Lightning1984/BlueDiamondPumpKNXInterface/Docu/StateChart.pdf

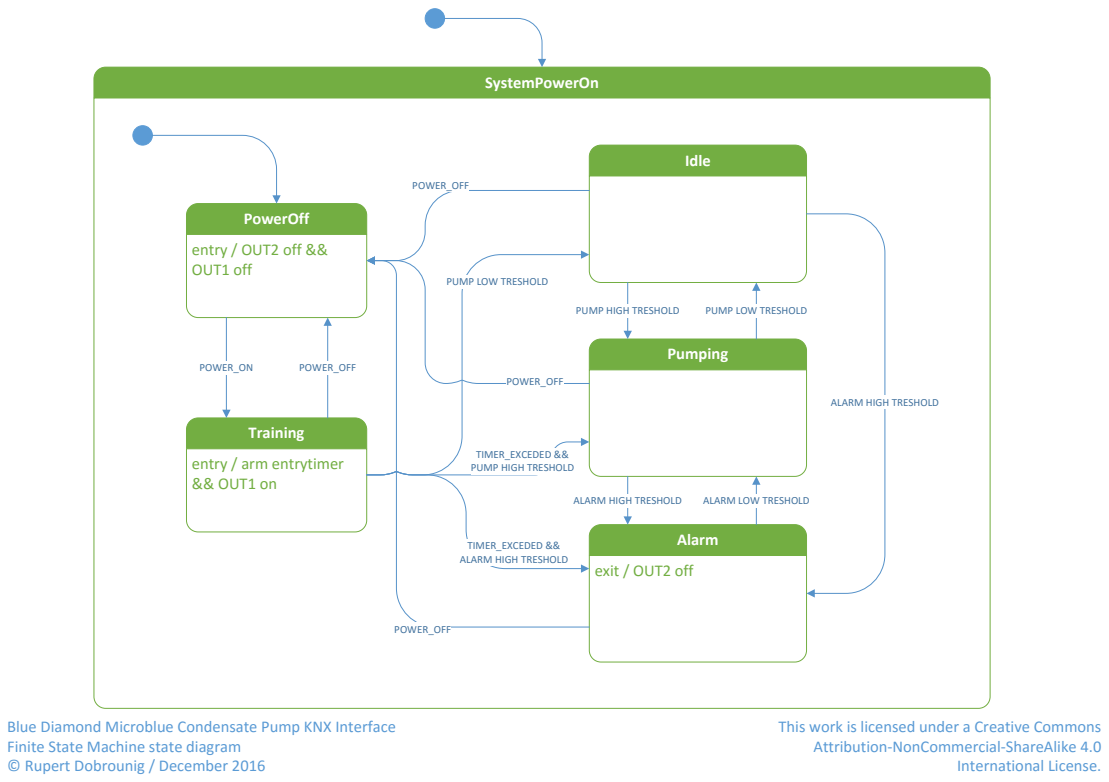
[picture p1: page 1]
SystemPowerOn; PowerOff; entry / OUT2 off && OUT1 off; Training; Idle; Pumping; Alarm; exit / OUT2 off; POWER_ON; POWER_OFF; ALARM HIGH TRESHOLD; ALARM LOW TRESHOLD; International License.

PUMP LOW TRESHOLD

PUMP HIGH TRESHOLD

ALARM HIGH TRESHOLD

TIMER_EXCEDED &&

entry / arm entrytimer
&& OUT1 on

Blue Diamond Microblue Condensate Pump KNX Interface
Finite State Machine state diagram
© Rupert Dobrounig / December 2016

This work is licensed under a Creative Commons
Attribution‐NonCommercial‐ShareAlike 4.0
