Lightning1984/BlueDiamondPumpKNXInterface/HW/LPC_2TE_3.11PEsmd_only-rdob-millable.brd

## EAGLE design HW/LPC_2TE_3.11PEsmd_only-rdob-millable.brd (2016-12-16)

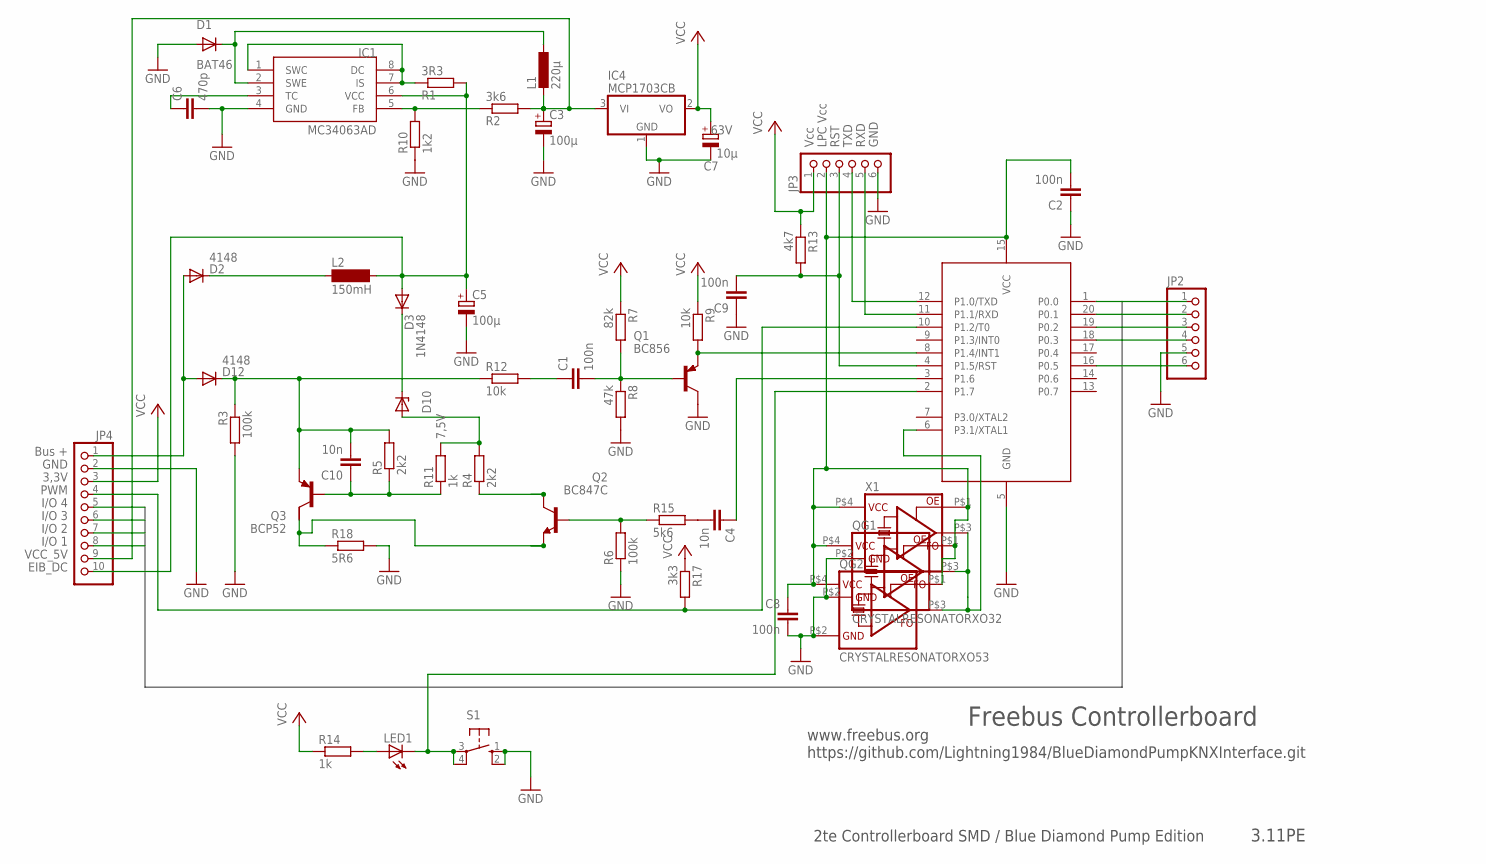
[picture p2: schematic LPC_2TE_3.11PEsmd_only-rdob-millable.sch]

Parts:
C1, C2, C8, C9: 100n; C0805K
C3: 100µ; E2,5-6
C4, C10: 10n; C0805K
C5: 100µ; E3,5-8
C6: 470p; C0805K
C7: 10µ; E2-5; VOLTAGE 63V
D1: BAT46; SOD-123
D2, D12: 4148; MINIMELF
D3: 1N4148; MINIMELF
D10: 7,5V; MINIMELF
IC1: MC34063AD; SOIC8
IC2: LPC922FDH; TSSOP20
IC4: MCP1703CB; SOT23
JP2: PINHD-1X06_2.54-0.70MM-DRILL; 1X06-0.70DRILL
JP3: PINHD-1X06_2.54-0.90MM-DRILL; 1X06-0.90DRILL
JP4: PINHD-1X10_2.54-S0.70MM-DRILL; 1X10-0.70DRILL
L1: 220µ; PIS28XX
L2: 150mH; BS11
LED1: LEDSMT1206; 1206
Q1: BC856; SOT23-BEC
Q2: BC847C; SOT23
Q3: BCP52; SOT223
QG1: CRYSTALRESONATORXO32; XO32
QG2: CRYSTALRESONATORXO53; XO53
R1: 3R3; R1206
R2: 3k6; R1206
R3, R6: 100k; R1206
R4, R5: 2k2; R1206
R7: 82k; R1206
R8: 47k; R1206
R9, R12: 10k; R1206
R10: 1k2; R1206
R11, R14: 1k; R1206
R13: 4k7; R1206
R15: 5k6; R1206
R17: 3k3; R1206
R18: 5R6; R1206
S1: 10-XX; B3F-10XX
X1: CRYSTALRESONATORXO91; XO91

Connections:
/RESET: C9.2, IC2.4 (P1.5/RST), JP3.3, R13.2
BASE: C1.2, Q1.B, R7.2, R8.1
BASE_SEND: Q2.1 (B), R6.2, R15.1
EIB+: D2.A, D12.A, JP4.1
EIB_DC: C5.+, D3.A, IC1.6 (VCC), JP4.10, L2.2, R1.2
FEEDBACK: IC1.5 (FB), R2.1, R10.2
GND: C2.1, C3.-, C5.-, C6.2, C7.-, C8.2, C9.1, D1.A, IC1.4 (GND), IC2.5 (GND), IC4.1 (GND), JP2.5, JP3.6, JP4.2, Q1.C, QG1.P$2 (GND), QG2.P$2 (GND), R3.2, R6.1, R8.2, R10.1, R18.2, S1.1 (S), S1.2 (S1), X1.P$2 (GND)
I_SENSE: Q2.2 (E), Q3.2 (C), R18.1
unnamed: Q2.3 (C), R4.1
unnamed: C10.2, D12.C, Q3.3 (E), R3.1, R5.2, R12.1
unnamed: IC2.6 (P3.1/XTAL1), QG1.P$3 (FO), QG2.P$3 (FO), X1.P$3 (FO)
unnamed: IC1.1 (SWC), IC1.7 (IS), IC1.8 (DC), R1.1
unnamed: LED1.A, R14.2
unnamed: D2.C, L2.1
unnamed: C6.1, IC1.3 (TC)
unnamed: D3.C, D10.C
unnamed: C1.1, R12.2
unnamed: C4.2, R15.2
unnamed: C10.1, Q3.1 (B), R5.1, R11.1
P0.0: IC2.1 (P0.0), JP2.1, JP4.8
P0.1: IC2.20 (P0.1), JP2.2, JP4.7
P0.2: IC2.19 (P0.2), JP2.3, JP4.6
P0.3: IC2.18 (P0.3), JP2.4, JP4.5
P0.5: IC2.16 (P0.5), JP2.6
PROG: IC2.2 (P1.7), LED1.C, S1.3, S1.4 (P1)
PWM: IC2.10 (P1.2/T0), JP4.4, R17.2
REFERENZ: D10.A, R4.2, R11.2
RXD: IC2.11 (P1.1/RXD), JP3.5
SIGIN: IC2.8 (P1.4/INT1), Q1.E, R9.2
SIGOUT: C4.1, IC2.3 (P1.6)
SWITCHED: D1.C, IC1.2 (SWE), L1.2 (1)
TXD: IC2.12 (P1.0/TXD), JP3.4
VCC: C7.+, IC4.2 (VO), JP3.1, JP4.3, R7.1, R9.1, R13.1, R14.1, R17.1
VCC_5V: C3.+, IC4.3 (VI), JP4.9, L1.1 (2), R2.2
VCC_LPC: C2.2, C8.1, IC2.15 (VCC), JP3.2, QG1.P$1 (OE), QG1.P$4 (VCC), QG2.P$1 (OE), QG2.P$4 (VCC), X1.P$1 (OE), X1.P$4 (VCC)

Notes on the sheet:
Bus +
GND
3,3V
PWM
I/O 1
I/O 2
I/O 3
I/O 4
Vcc
LPC Vcc
RST
TXD
RXD
VCC_5V
Freebus Controllerboard
www.freebus.org https://github.com/Lightning1984/BlueDiamondPumpKNXInterface.git
2te Controllerboard SMD / Blue Diamond Pump Edition
3.11PE
EIB_DC

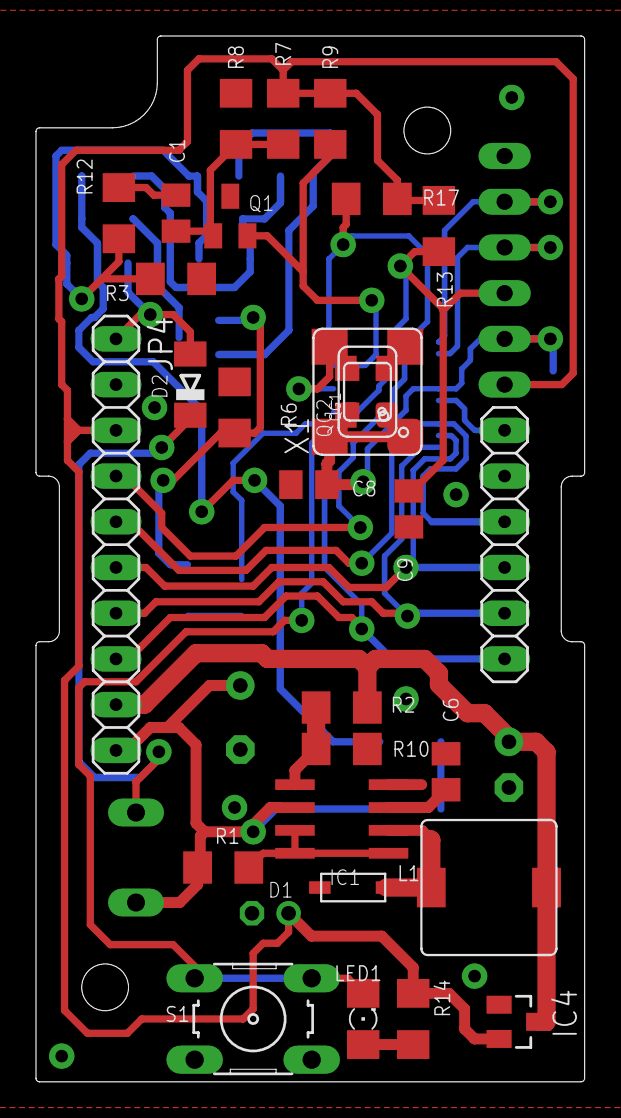
[picture p3: board LPC_2TE_3.11PEsmd_only-rdob-millable.brd from above]

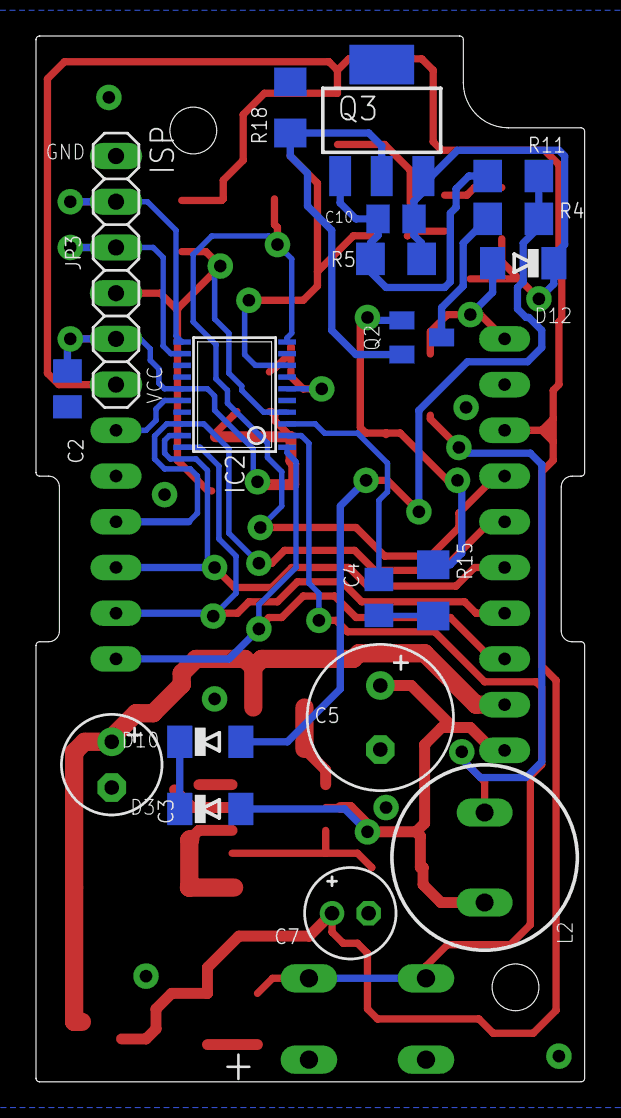
[picture p4: board LPC_2TE_3.11PEsmd_only-rdob-millable.brd from below]

Board: 2 copper layers, 30.5 x 58.1 mm, 48 parts (19 on the bottom side), 35 nets.
