Lightning1984/BlueDiamondPumpKNXInterface/HW/MicroBlue-CPU+PSU_1.0_rdob-millable.brd

## EAGLE design HW/MicroBlue-CPU+PSU_1.0_rdob-millable.brd (2016-12-16)

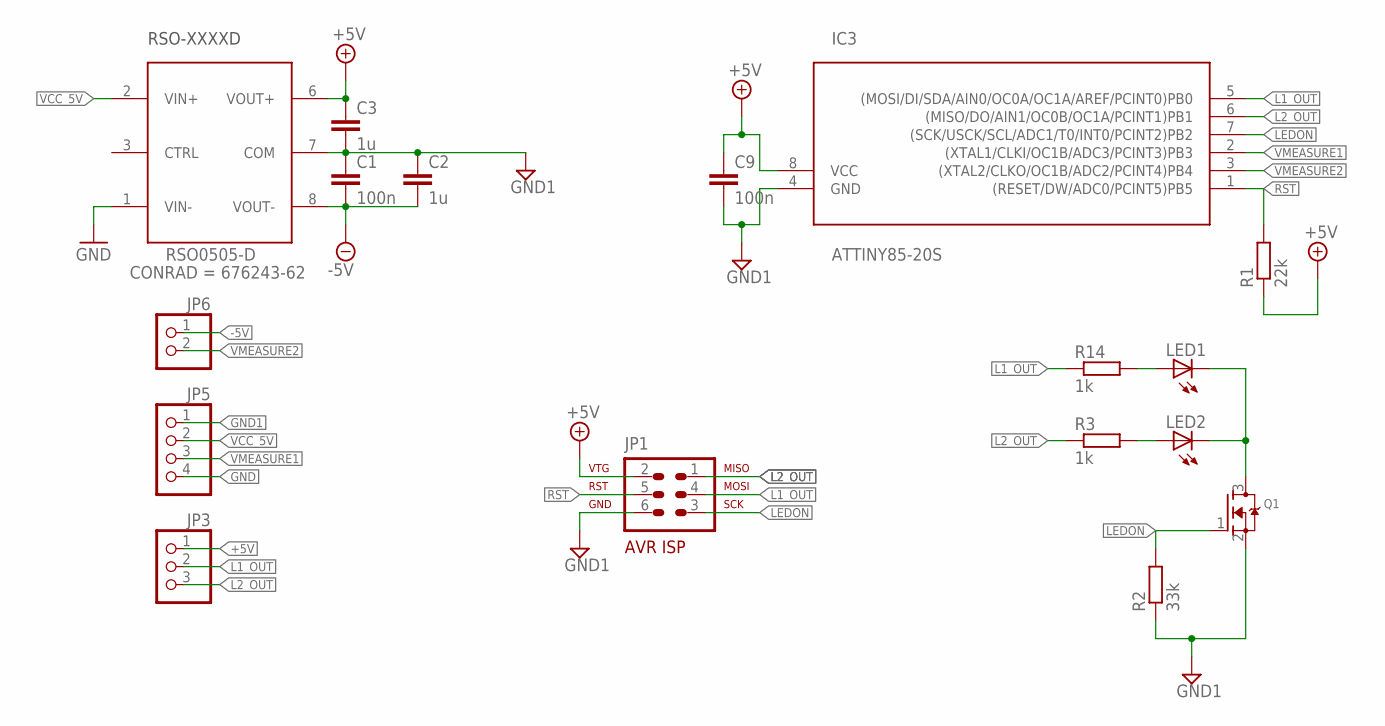
[picture p5: schematic MicroBlue-CPU+PSU_1.0_rdob-millable.sch]

Parts:
C1, C9: 100n; C0805K
C2, C3: 1u; C0805K
IC3: ATTINY85-20S; SOIC8
JP1: AVR-ISP-6R
JP3: PINHD-1X03_2.54-0.90MM-DRILL; 1X03-0.90DRILL
JP5: PINHD-1X04_2.54-0.90MM-DRILL; 1X04-0.90DRILL
JP6: PINHD-1X02_2.54-0.90MM-DRILL; 1X02-0.90DRILL
LED1, LED2: LEDSMT1206; 1206
Q1: MOSFET-NREFLOW; SOT23
R1: 22k; R1206
R2: 33k; R1206
R3, R14: 1k; R1206
RSO0505-D: RSO-0505D; RSO-XXXX

Connections:
+5V: C3.1, C9.1, IC3.8 (VCC), JP1.2, JP3.1, R1.1, RSO0505-D.6 (VOUT+)
-5V: C1.2, C2.2, JP6.1, RSO0505-D.8 (VOUT-)
GND: JP5.4, RSO0505-D.1 (VIN-)
GND1: C1.1, C2.1, C3.2, C9.2, IC3.4 (GND), JP1.6, JP5.1, Q1.2 (S), R2.1, RSO0505-D.7 (COM)
L1_OUT: IC3.5 ((MOSI/DI/SDA/AIN0/OC0A/OC1A/AREF/PCINT0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), JP1.4, JP3.2, R14.1
L2_OUT: IC3.6 ((MISO/DO/AIN1/OC0B/OC1A/PCINT1)PB1), JP1.1, JP3.3, R3.1
LEDON: IC3.7 ((SCK/USCK/SCL/ADC1/T0/INT0/PCINT2)PB2), JP1.3, Q1.1 (G), R2.2
unnamed: LED2.A, R3.2
unnamed: LED1.A, R14.2
PROG: LED1.C, LED2.C, Q1.3 (D)
RST: IC3.1 ((RESET/DW/ADC0/PCINT5)PB5), JP1.5, R1.2
VCC_5V: JP5.2, RSO0505-D.2 (VIN+)
VMEASURE1: IC3.2 ((XTAL1/CLKI/OC1B/ADC3/PCINT3)PB3), JP5.3
VMEASURE2: IC3.3 ((XTAL2/CLKO/OC1B/ADC2/PCINT4)PB4), JP6.2

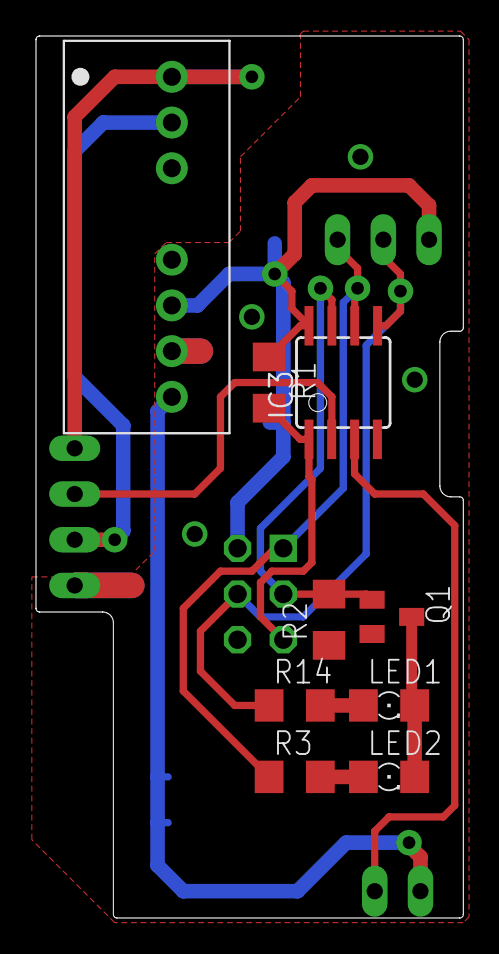
[picture p6: board MicroBlue-CPU+PSU_1.0_rdob-millable.brd from above]

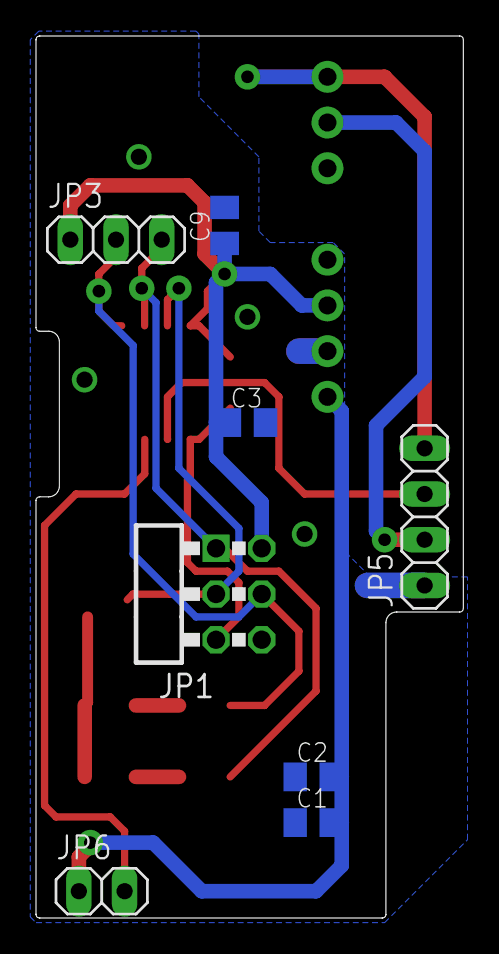
[picture p7: board MicroBlue-CPU+PSU_1.0_rdob-millable.brd from below]

Board: 2 copper layers, 23.7 x 49.0 mm, 17 parts (8 on the bottom side), 14 nets.
