Lightning1984/BlueDiamondPumpKNXInterface/HW/MicroBlue_1.0_rdob-millable.brd

## EAGLE design HW/MicroBlue_1.0_rdob-millable.brd (2016-12-16)

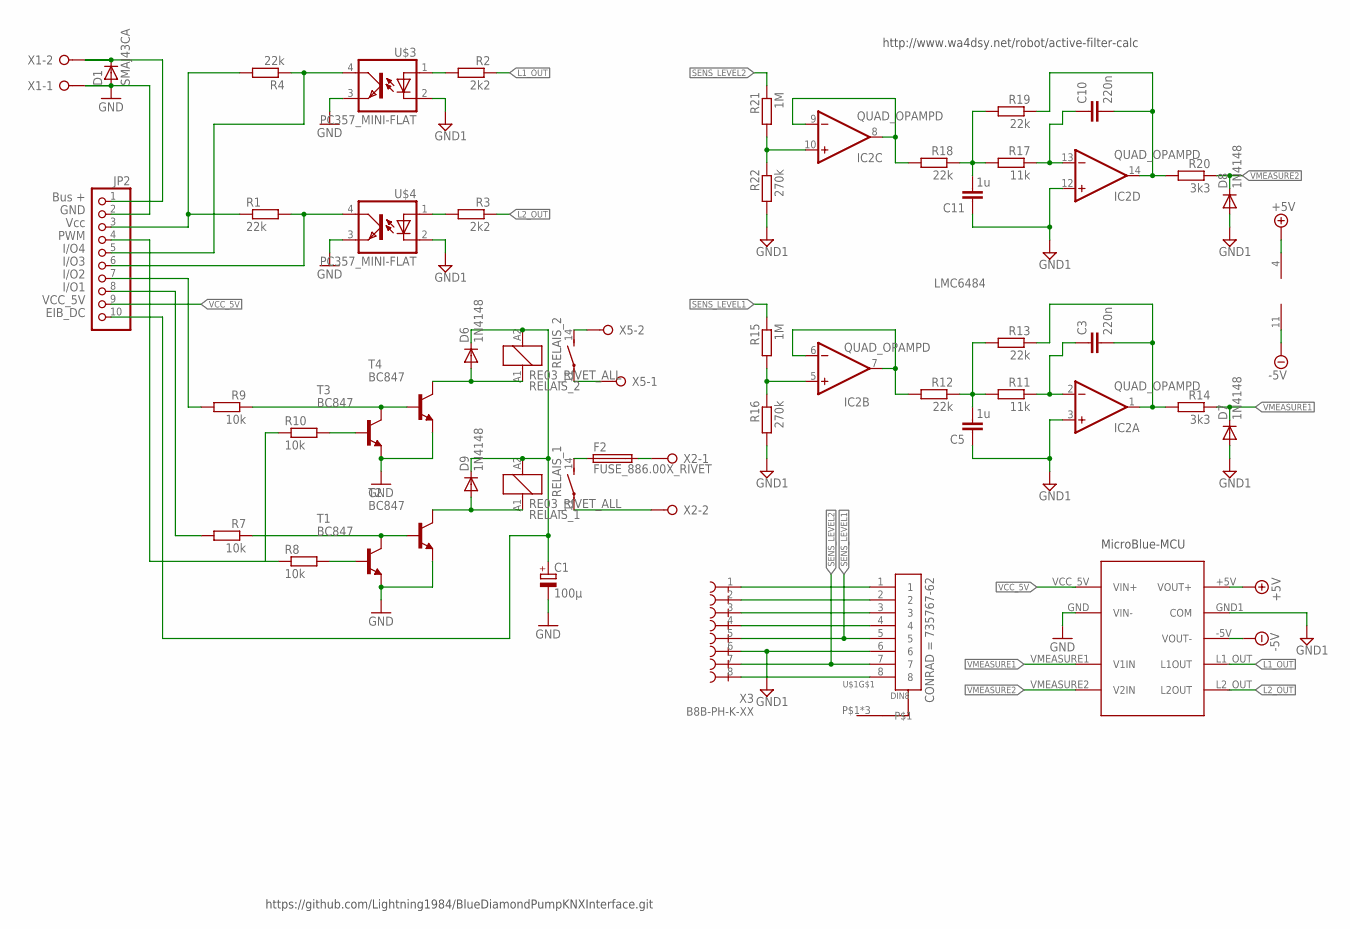
[picture p8: schematic MicroBlue_1.0_rdob-millable.sch]

Parts:
C1: 100µ; E3,5-8
C3, C10: 220n; C0805K
C5, C11: 1u; C0805K
D1: SMAJ43CA; SMB
D6, D7, D8, D9: 1N4148; MINIMELF
F2: FUSE_886.00X_RIVET; 886.00X_RIVET
IC2: QUAD_OPAMPD; SO14
JP2: PINHD-1X10_2.54-S0.90MM-DRILL; 1X10-0.90DRILL
R1, R4, R12, R13, R18, R19: 22k; M1206
R2, R3: 2k2; M1206
R7, R8, R9, R10: 10k; M1206
R11, R17: 11k; M1206
R14, R20: 3k3; M1206
R15, R21: 1M; M1206
R16, R22: 270k; M1206
RELAIS_1, RELAIS_2: RE03_RIVET_ALL; G5Q-SPST-RIVET-ALL
T1, T2, T3, T4: BC847; SOT23
U$1: DIN8
U$3, U$4: PC357_MINI-FLAT; PC357
U$5: MICROBLUE-MCU_V2; MICROBLUE-MCU-V2
X1: W237-02PNORMAL; W237-132
X2, X5: W237-02P_RIVET; W237-132-RIVET
X3: B8B-PH-K-XX

Connections:
+5V: IC2.4 (V+), U$5.+5V (VOUT+)
-5V: IC2.11 (V-), U$5.-5V (VOUT-)
EIB+: D1.1 (C), JP2.1, X1.2
EIB_DC: C1.+, D6.C, D9.C, JP2.10, RELAIS_1.A2 (2), RELAIS_2.A2 (2)
GND: C1.-, D1.2 (A), JP2.2, T1.2 (E), T2.2 (E), T3.2 (E), T4.2 (E), U$3.3 (EMIT), U$4.3 (EMIT), U$5.GND (VIN-), X1.1
GND1: C5.1, C11.1, D7.A, D8.A, IC2.3 (+IN), IC2.12 (+IN), R16.2, R22.2, U$1.6, U$3.2 (C), U$4.2 (C), U$5.GND1 (COM), X3.6
IO1: JP2.7, R9.2
IO2: JP2.8, R7.2
IO3: JP2.6, R1.2, U$4.4 (COL)
IO4: JP2.5, R4.1, U$3.4 (COL)
L1_OUT: R2.1, U$5.L1_OUT (L1OUT)
L2_OUT: R3.1, U$5.L2_OUT (L2OUT)
unnamed: U$1.1, X3.1
unnamed: RELAIS_1.11, X2.2
unnamed: U$1.2, X3.2
unnamed: U$1.4, X3.4
unnamed: U$1.3, X3.3
unnamed: F2.1, RELAIS_1.14 (S)
unnamed: U$1.8, X3.8
unnamed: RELAIS_2.14 (S), X5.2
unnamed: RELAIS_2.11, X5.1
unnamed: F2.2, X2.1
unnamed: C5.2, R11.2, R12.1, R13.2
unnamed: R2.2, U$3.1 (A)
unnamed: R3.2, U$4.1 (A)
unnamed: R7.1, T1.3 (C), T2.1 (B)
unnamed: C3.2, IC2.1 (OUT), R13.1, R14.2
unnamed: R9.1, T3.3 (C), T4.1 (B)
unnamed: D6.A, RELAIS_2.A1 (1), T4.3 (C)
unnamed: R8.2, T1.1 (B)
unnamed: R10.2, T3.1 (B)
unnamed: C3.1, IC2.2 (-IN), R11.1
unnamed: IC2.6 (-IN), IC2.7 (OUT), R12.2
unnamed: IC2.5 (+IN), R15.2, R16.1
unnamed: C11.2, R17.2, R18.1, R19.2
unnamed: C10.2, IC2.14 (OUT), R19.1, R20.2
unnamed: C10.1, IC2.13 (-IN), R17.1
unnamed: IC2.8 (OUT), IC2.9 (-IN), R18.2
unnamed: IC2.10 (+IN), R21.2, R22.1
PWM: JP2.4, R8.1, R10.1
R3: D9.A, RELAIS_1.A1 (1), T2.3 (C)
SENS_LEVEL1: R15.1, U$1.5, X3.5
SENS_LEVEL2: R21.1, U$1.7, X3.7
VCC: JP2.3, R1.1, R4.2
VCC_5V: JP2.9, U$5.VCC_5V (VIN+)
VMEASURE1: D7.C, R14.1, U$5.VMEASURE1 (V1IN)
VMEASURE2: D8.C, R20.1, U$5.VMEASURE2 (V2IN)

Notes on the sheet:
Bus +
GND
Vcc
PWM
I/O4
I/O3
I/O2
I/O1
http://www.wa4dsy.net/robot/active-filter-calc
EIB_DC
VCC_5V
https://github.com/Lightning1984/BlueDiamondPumpKNXInterface.git

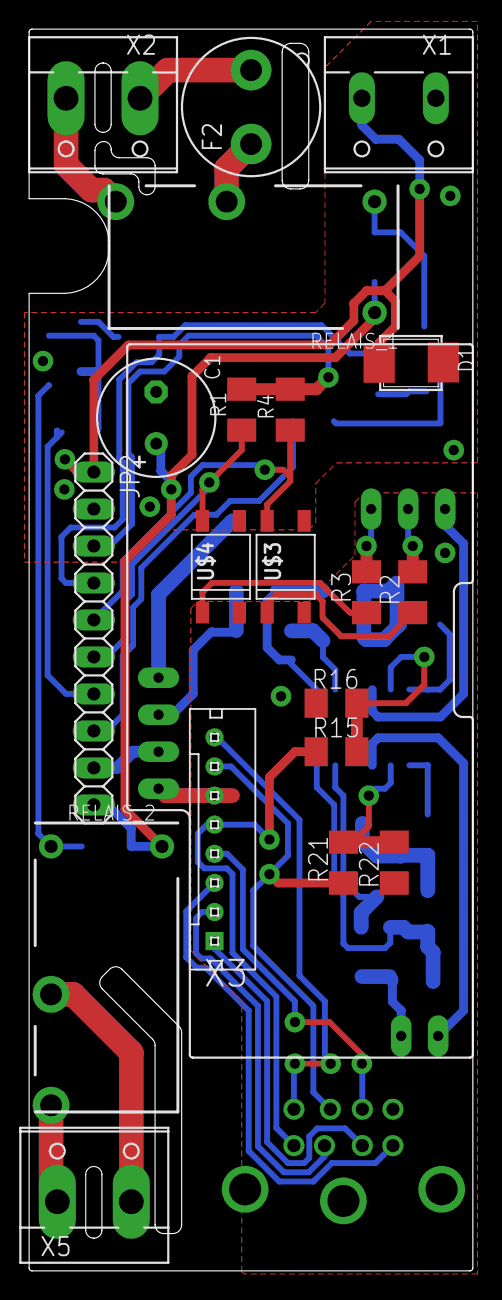
[picture p9: board MicroBlue_1.0_rdob-millable.brd from above]

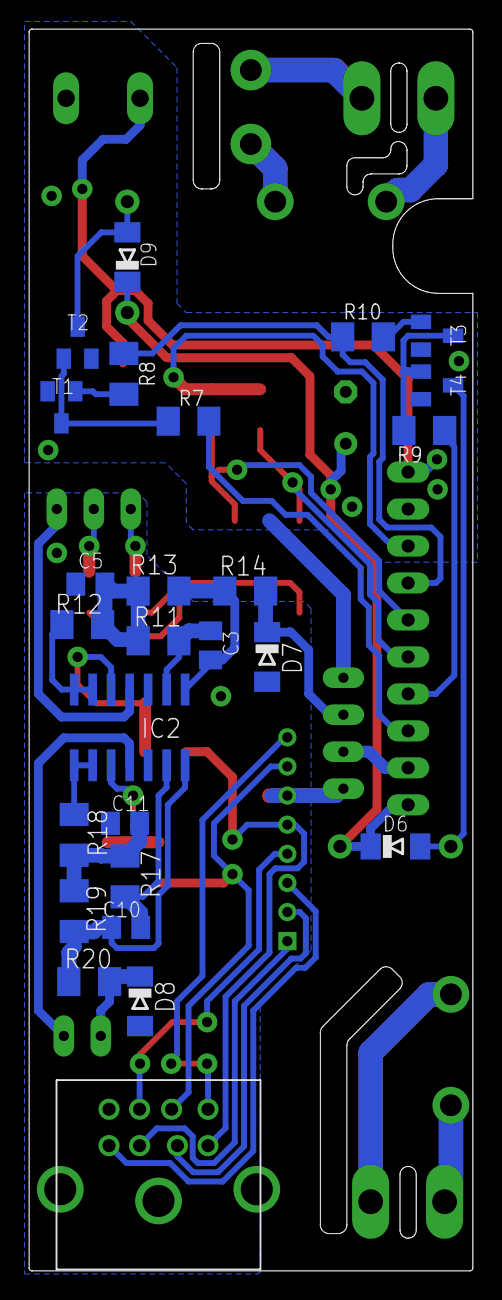
[picture p10: board MicroBlue_1.0_rdob-millable.brd from below]

Board: 2 copper layers, 30.5 x 85.3 mm, 47 parts (25 on the bottom side), 47 nets.
